rhammell/esp32-diff-drive/mechanical/export/MDD32_Bot-Chasis.stl

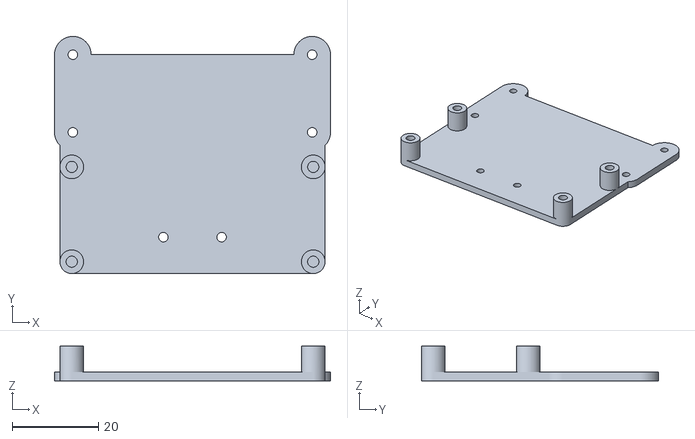
[picture p2: CAD file, 2026-10-17]
mechanical/export/MDD32_Bot-Chasis.stl
64.0 x 55.0 x 8.00
