rhammell/esp32-diff-drive/mechanical/src/MDD32_Bot.FCStd

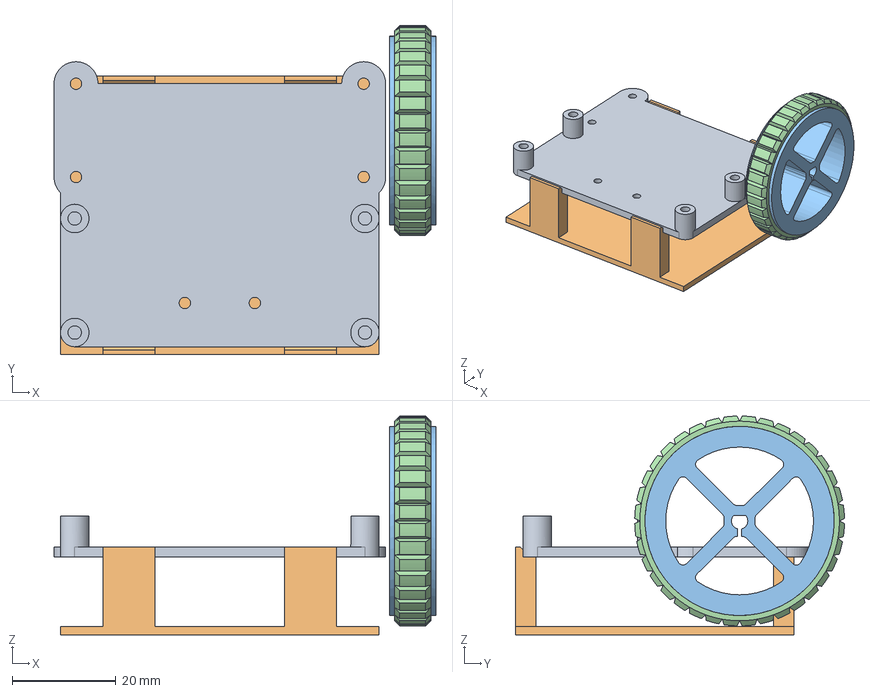
[picture p3: CAD file, 2026-10-17]
mechanical/src/MDD32_Bot.FCStd
73.7 x 63.5 x 42.2 mm
Chasis
Stand
Wheel
Tire
