rhammell/esp32-diff-drive/mechanical/export/MDD32_Bot-Stand.stl

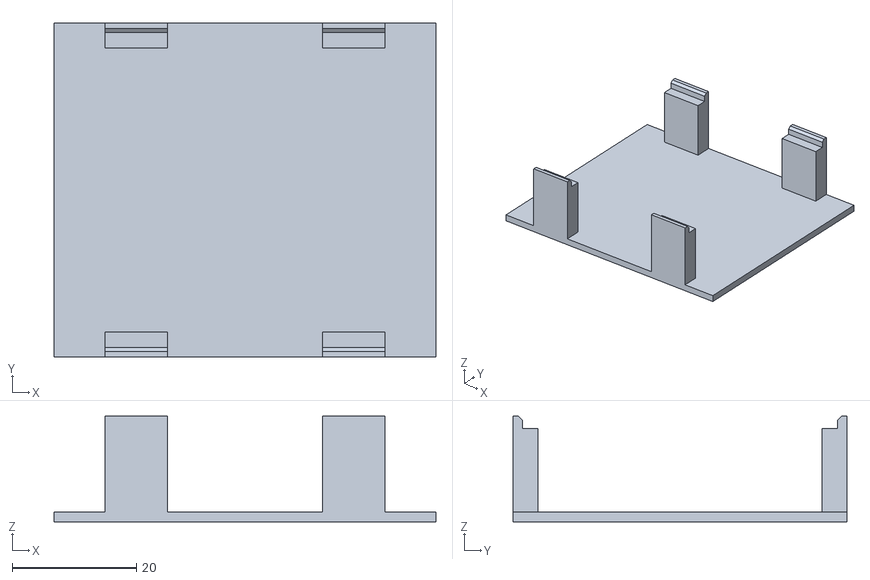
[picture p4: CAD file, 2026-10-17]
mechanical/export/MDD32_Bot-Stand.stl
61.5 x 53.7 x 17.0
