rhammell/esp32-diff-drive/mechanical/export/MDD32_Bot-Tire.stl

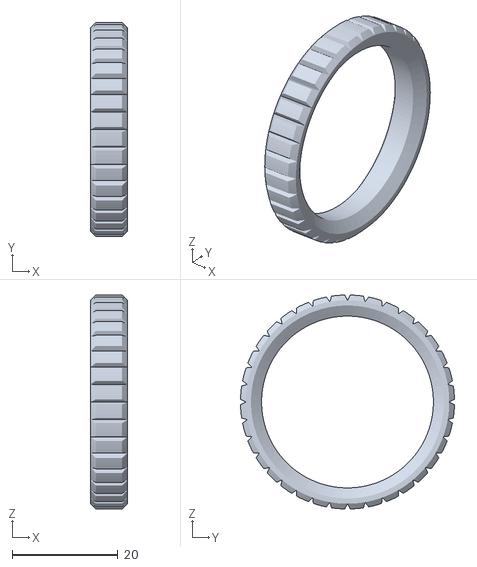
[picture p5: CAD file, 2026-10-17]
mechanical/export/MDD32_Bot-Tire.stl
7.00 x 40.5 x 40.5
