rhammell/esp32-diff-drive/mechanical/export/MDD32_Bot-Wheel.stl

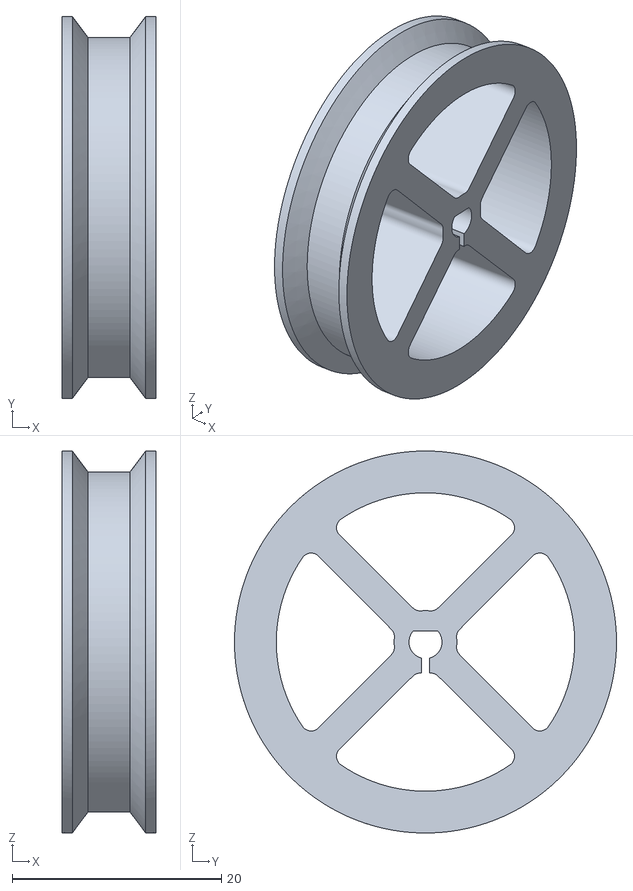
[picture p6: CAD file, 2026-10-17]
mechanical/export/MDD32_Bot-Wheel.stl
9.00 x 36.5 x 36.5
