rhammell/esp32-diff-drive/hardware/MDD32_Bot/MDD32_Bot.kicad_pcb

## KiCad design hardware/MDD32_Bot/MDD32_Bot.kicad_pcb (2026-10-15)

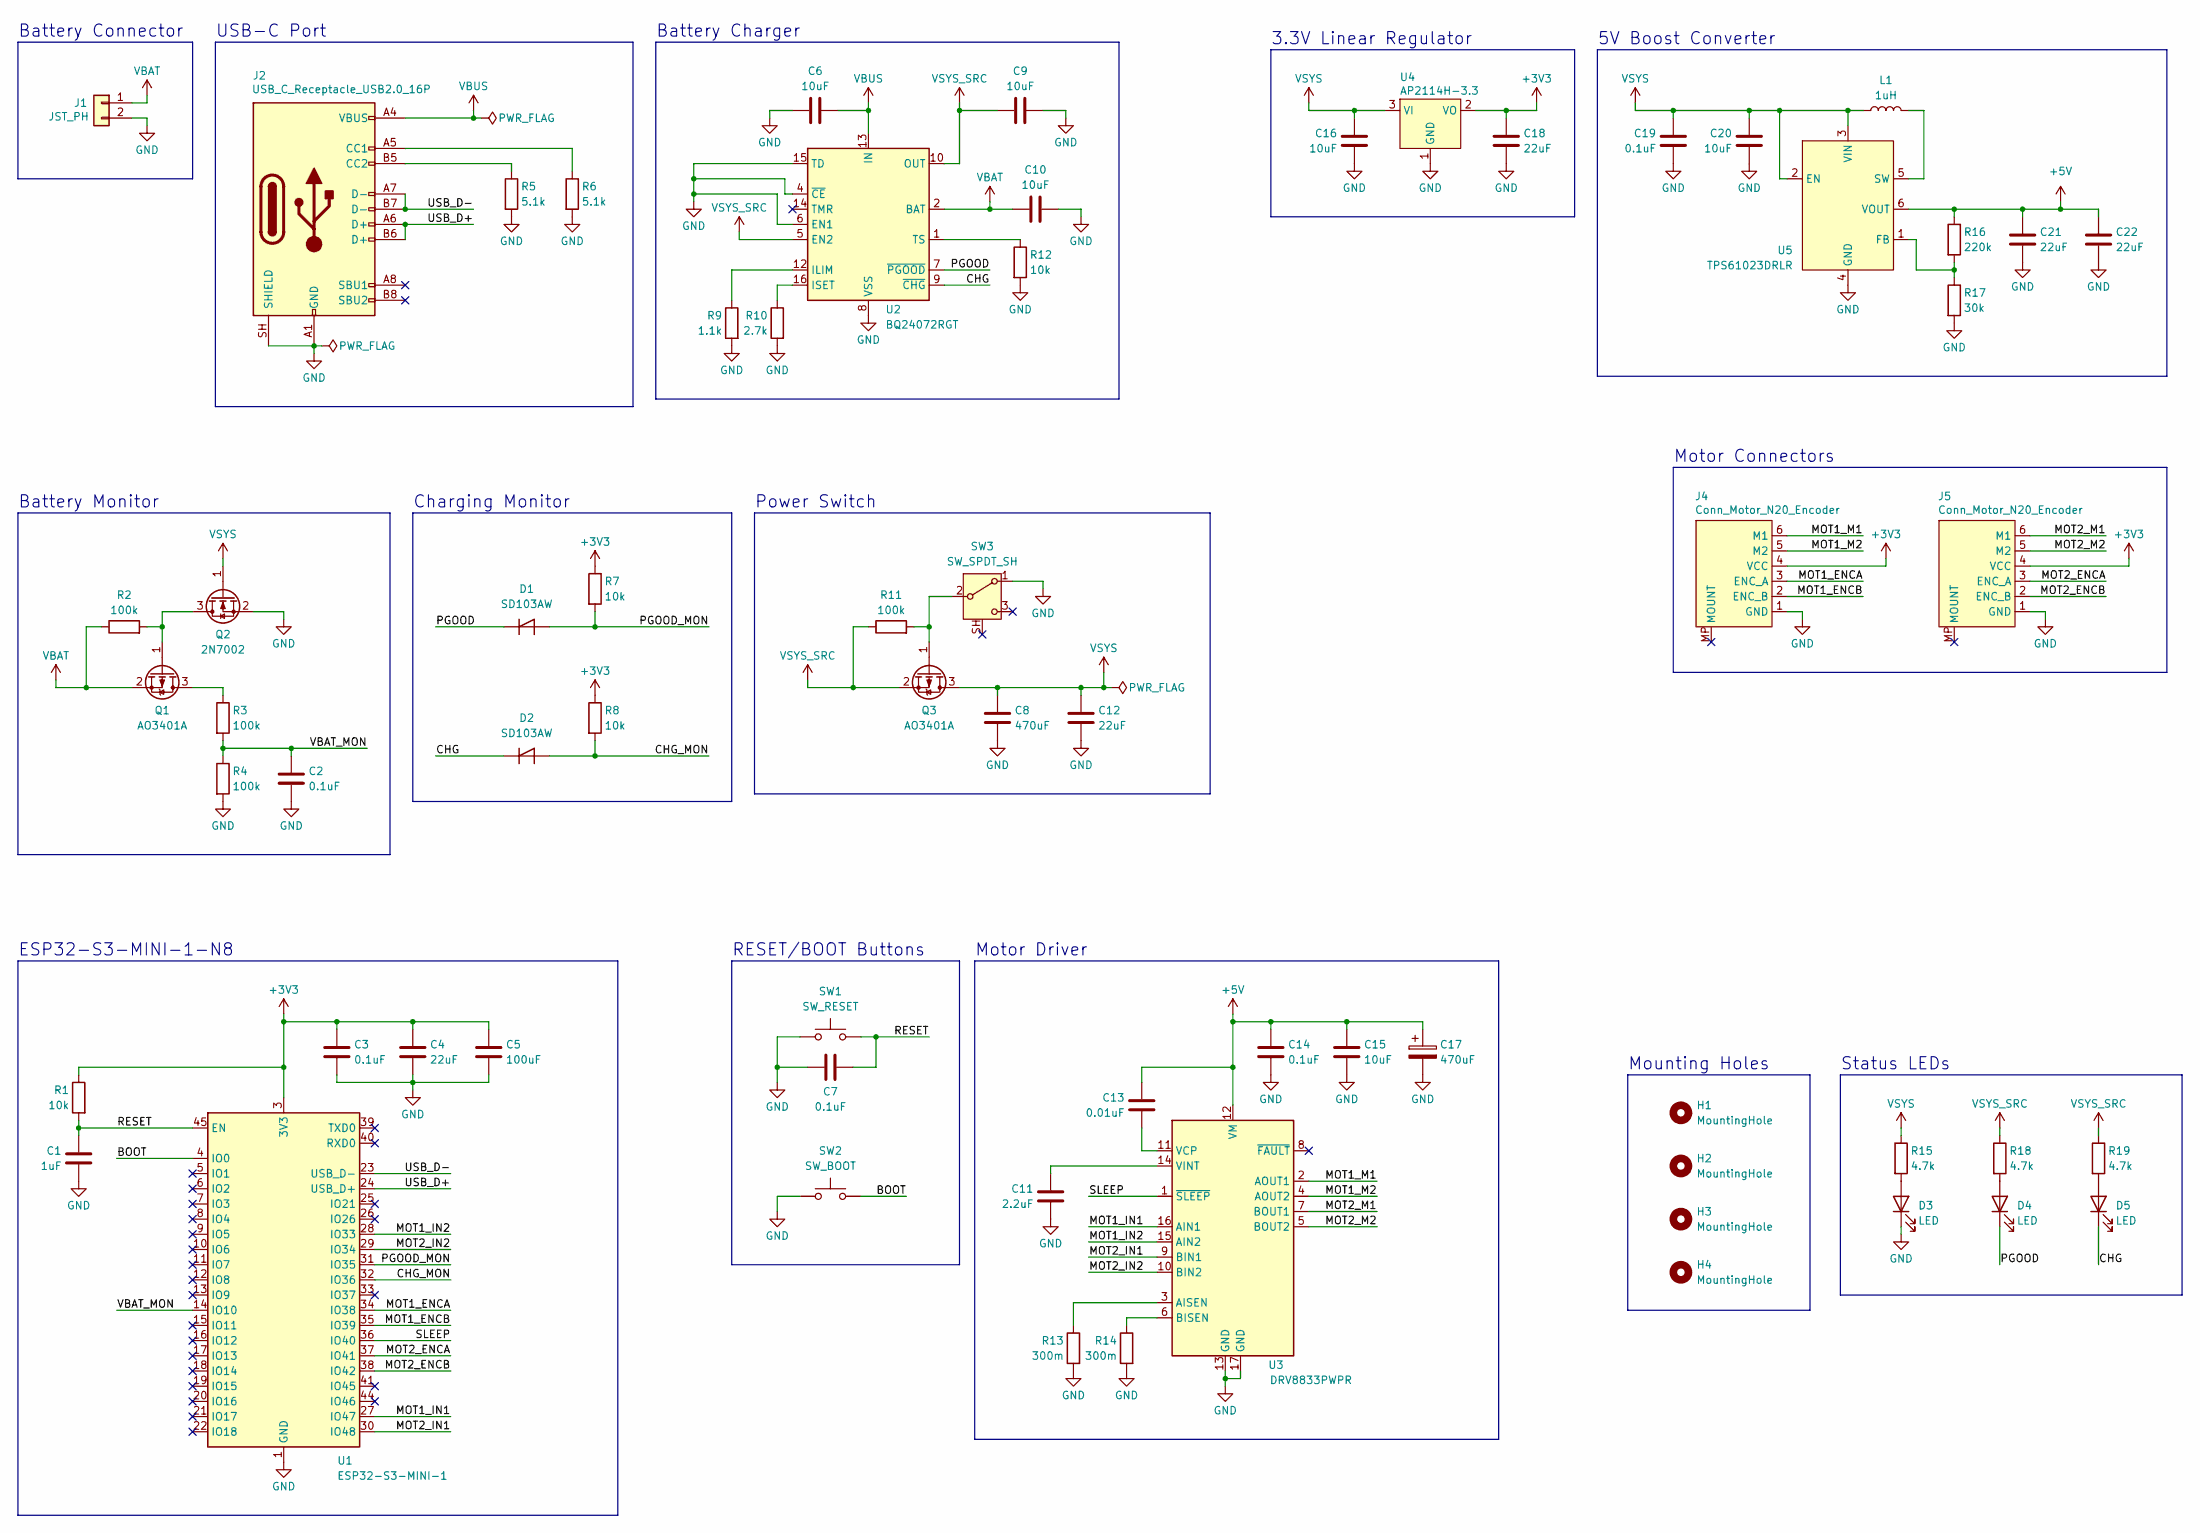
[picture p7: schematic MDD32_Bot.kicad_sch, MDD32 Bot]

Parts:
C1: 1uF; C_0603_1608Metric; LCSC C15849
C2, C3, C7, C14, C19: 0.1uF; C_0603_1608Metric; LCSC C14663
C4, C12, C18, C21, C22: 22uF; C_0805_2012Metric; LCSC C45783
C5: 100uF; C_1206_3216Metric; LCSC C15008
C6, C9, C10, C15, C16, C20: 10uF; C_0805_2012Metric; LCSC C15850
C8, C17: 470uF; CP_Elec_6.3x7.7; LCSC C344072
C11: 2.2uF; C_0603_1608Metric; LCSC C23630
C13: 0.01uF; C_0603_1608Metric; LCSC C57112
D1, D2: SD103AW; D_SOD-123; LCSC C7502706
D3: LED; LED_0805_2012Metric; LCSC C2297
D4, D5: LED; LED_0805_2012Metric; LCSC C2296
H1, H2, H3, H4: MountingHole; MountingHole_2.7mm_M2.5
J1: JST_PH; JST_PH_B2B-PH-K_1x02_P2.00mm_Vertical; LCSC C131337
J2: USB_C_Receptacle_USB2.0_16P; USB_C_Receptacle_G-Switch_GT-USB-7010ASV; LCSC C2988369
J4, J5: Conn_Motor_N20_Encoder; JST_SH_BM06B-SRSS-TB_1x06-1MP_P1.00mm_Vertical; LCSC C495540
L1: 1uH; L_Coilcraft_XxL4030; LCSC C5441341
Q1, Q3: AO3401A; SOT-23; LCSC C15127
Q2: 2N7002; SOT-23; LCSC C8545
R1, R7, R8, R12: 10k; R_0603_1608Metric; LCSC C25804
R2, R3, R4, R11: 100k; R_0603_1608Metric; LCSC C25803
R5, R6: 5.1k; R_0603_1608Metric; LCSC C23186
R9: 1.1k; R_0603_1608Metric; LCSC C22764
R10: 2.7k; R_0603_1608Metric; LCSC C13167
R13, R14: 300m; R_1206_3216Metric; LCSC C22464904
R15, R18, R19: 4.7k; R_0603_1608Metric; LCSC C23162
R16: 220k; R_0603_1608Metric; LCSC C22961
R17: 30k; R_0603_1608Metric; LCSC C22984
SW1: SW_RESET; SW_SPST_TS-1088-xR020; LCSC C720477
SW2: SW_BOOT; SW_SPST_TS-1088-xR020; LCSC C720477
SW3: SW_SPDT_SH; SW_SPDT_Shouhan_MSK12C02; LCSC C431541
U1: ESP32-S3-MINI-1; LCSC C2913206
U2: BQ24072RGT; VQFN-16-1EP_3x3mm_P0.5mm_EP1.6x1.6mm_ThermalVias; LCSC C140288
U3: DRV8833PWPR; HTSSOP-16-1EP_4.4x5mm_P0.65mm_EP3.4x5mm_Mask2.66x2.46mm_The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; LCSC C50506
U4: AP2114H-3.3; SOT-223-3_TabPin2; LCSC C150716
U5: TPS61023DRLR; SOT-563; LCSC C919459

Connections:
+3V3: C3.1, C4.1, C5.1, C18.1, J4.4 (VCC), J5.4 (VCC), R1.1, R7.1, R8.1, U1.3 (3V3), U4.2 (VO)
+5V: C13.1, C14.1, C15.1, C17.1, C21.1, C22.1, R16.1, U3.12 (VM), U5.6 (VOUT)
/BOOT: SW2.2, U1.4 (IO0)
/CHG: D2.1 (K), D5.1 (K), U2.9 (~CHG)
/CHG_MON: D2.2 (A), R8.2, U1.32 (IO36)
/CS: U1.21 (IO17)
/DC: U1.19 (IO15)
/LITE: U1.16 (IO12)
/MOSI: U1.18 (IO14)
/MOT1_ENCA: J4.3 (ENC_A), U1.34 (IO38)
/MOT1_ENCB: J4.2 (ENC_B), U1.35 (IO39)
/MOT1_IN1: U1.27 (IO47), U3.16 (AIN1)
/MOT1_IN2: U1.28 (IO33), U3.15 (AIN2)
/MOT1_M1: J4.6 (M1), U3.2 (AOUT1)
/MOT1_M2: J4.5 (M2), U3.4 (AOUT2)
/MOT2_ENCA: J5.3 (ENC_A), U1.37 (IO41)
/MOT2_ENCB: J5.2 (ENC_B), U1.38 (IO42)
/MOT2_IN1: U1.30 (IO48), U3.9 (BIN1)
/MOT2_IN2: U1.29 (IO34), U3.10 (BIN2)
/MOT2_M1: J5.6 (M1), U3.7 (BOUT1)
/MOT2_M2: J5.5 (M2), U3.5 (BOUT2)
/PGOOD: D1.1 (K), D4.1 (K), U2.7 (~PGOOD)
/PGOOD_MON: D1.2 (A), R7.2, U1.31 (IO35)
/RESET: C1.1, C7.1, R1.2, SW1.2, U1.45 (EN)
/RST: U1.20 (IO16)
/SCK: U1.17 (IO13)
/SCL: U1.22 (IO18)
/SDA: U1.25 (IO21)
/SLEEP: U1.36 (IO40), U3.1 (~SLEEP)
/USB_D+: J2.A6 (D+), J2.B6 (D+), U1.24 (USB_D+)
/USB_D-: J2.A7 (D-), J2.B7 (D-), U1.23 (USB_D-)
/VBAT_MON: C2.1, R3.2, R4.1, U1.14 (IO10)
GND: C1.2, C2.2, C3.2, C4.2, C5.2, C6.1, C7.2, C8.2, C9.2, C10.2, C11.2, C12.2, C14.2, C15.2, C16.2, C17.2, C18.2, C19.2, C20.2, C21.2, C22.2, D3.1 (K), J1.2, J2.A1 (GND), J2.A12 (GND), J2.B1 (GND), J2.B12 (GND), J2.S1 (SHIELD), J2.SH (SHIELD), J4.1 (GND), J5.1 (GND), Q2.2 (S), R4.2, R5.2, R6.2, R9.2, R10.2, R12.2, R13.2, R14.2, R17.2, SW1.1, SW2.1, SW3.1 (A), U1.1 (GND), U1.2 (GND), U1.42 (GND), U1.43 (GND), U1.46 (GND), U1.47 (GND), U1.48 (GND), U1.49 (GND), U1.50 (GND), U1.51 (GND), U1.52 (GND), U1.53 (GND), U1.54 (GND), U1.55 (GND), U1.56 (GND), U1.57 (GND), U1.58 (GND), U1.59 (GND), U1.60 (GND), U1.61 (GND), U1.62 (GND), U1.63 (GND), U1.64 (GND), U1.65 (GND), U2.4 (~CE), U2.6 (EN1), U2.8 (VSS), U2.15 (TD), U2.17 (VSS), U3.13 (GND), U3.17 (GND), U4.1 (GND), U5.4 (GND)
unnamed: D3.2 (A), R15.2
unnamed: D4.2 (A), R18.2
unnamed: D5.2 (A), R19.2
unnamed: J2.A5 (CC1), R6.1
unnamed: J2.B5 (CC2), R5.1
unnamed: Q1.3 (D), R3.1
unnamed: Q1.1 (G), Q2.3 (D), R2.2
unnamed: Q3.1 (G), R11.2, SW3.2 (B)
unnamed: R9.1, U2.12 (ILIM)
unnamed: R10.1, U2.16 (ISET)
unnamed: R12.1, U2.1 (TS)
unnamed: R13.1, U3.3 (AISEN)
unnamed: R14.1, U3.6 (BISEN)
unnamed: C13.2, U3.11 (VCP)
unnamed: C11.1, U3.14 (VINT)
unnamed: R16.2, R17.1, U5.1 (FB)
unnamed: L1.2, U5.5 (SW)
VBAT: C10.1, J1.1, Q1.2 (S), R2.1, U2.2 (BAT), U2.3 (BAT)
VBUS: C6.2, J2.A4 (VBUS), J2.A9 (VBUS), J2.B4 (VBUS), J2.B9 (VBUS), U2.13 (IN)
VSYS: C8.1, C12.1, C16.1, C19.1, C20.1, L1.1, Q2.1 (G), Q3.3 (D), R15.1, U4.3 (VI), U5.2 (EN), U5.3 (VIN)
VSYS_SRC: C9.1, Q3.2 (S), R11.1, R18.1, R19.1, U2.5 (EN2), U2.10 (OUT), U2.11 (OUT)

Notes on the sheet:
Motor Connectors
ESP32-S3-MINI-1-N8
RESET/BOOT Buttons
Battery Charger
Battery Monitor
Charging Monitor
5V Boost Converter
Status LEDs
3.3V Linear Regulator
Mounting Holes
USB-C Port
Battery Connector
Power Switch
Motor Driver

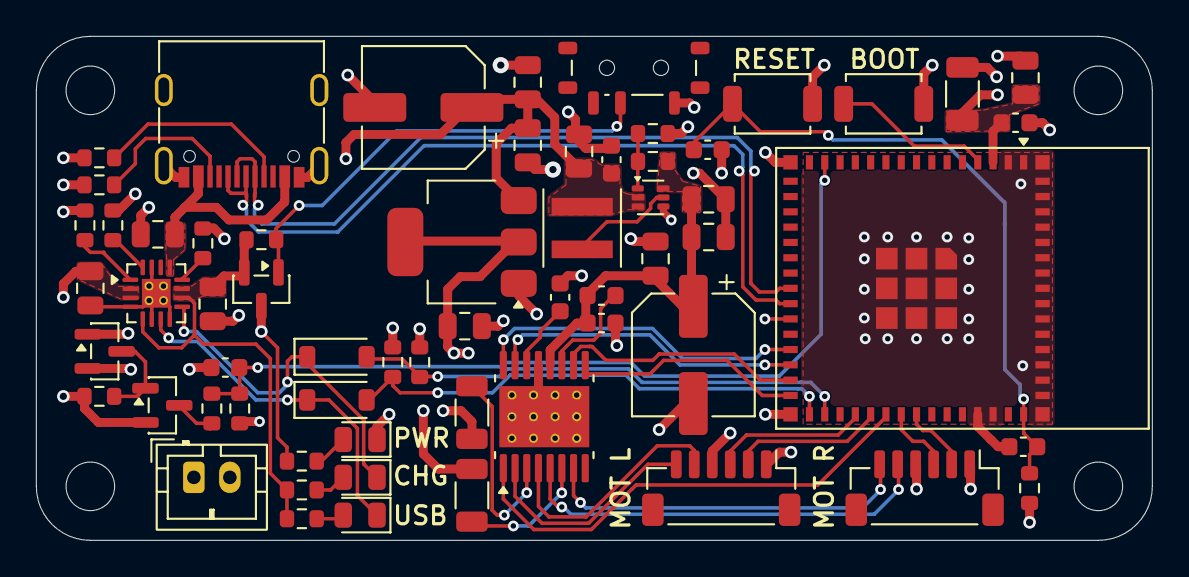
[picture p8: board MDD32_Bot.kicad_pcb from above]

Board: 4 copper layers, 62.0 x 28.0 mm, 66 parts (0 on the bottom side), 46 nets.
