rhammell/esp32-diff-drive/firmware/MDD32_Bot/src/drive/MDD32_Motor.h

#pragma once

#include <Arduino.h>

// Controls a single motor channel on the DRV8833 H-bridge.
// PWM sign controls direction, magnitude controls duty cycle.
class MDD32_Motor {
public:
    MDD32_Motor() = default;

    void begin(uint8_t in1Pin, uint8_t in2Pin, bool flip = false);
    void setPWM(int pwm);   // -255 to +255 (sign = direction)
    void stop();

private:
    uint8_t _in1Pin = 0;
    uint8_t _in2Pin = 0;
};
