rhammell/esp32-diff-drive/(commit log)

2026-10-10 Initial commit: ESP32 diff drive KiCad project
    [ESP32_Diff_Drive.kicad_pcb, ESP32_Diff_Drive.kicad_sch]
2026-10-10 Add top-down board render to README
2026-10-10 Crop README board image
2026-10-15 Restructure repo as MDD32 Bot; add firmware and mechanical
    [MDD32_Bot.FCStd, MDD32_Bot.kicad_pcb, MDD32_Bot.kicad_sch]
2026-10-16 Update mechanical model
    [MDD32_Bot.FCStd]
2026-10-17 Add wheel and tire; export STLs
    [MDD32_Bot-Chasis.stl, MDD32_Bot-Stand.stl, MDD32_Bot-Tire.stl, MDD32_Bot-Wheel.stl, MDD32_Bot.FCStd]
